fieldkit/core/(commit log)

2017-01-18 Starting the fk-core module schematic. This is pretty rough.
    Basically a combination of the various prototypes we've been using. Gotta
    start somewhere.
    [fk-core.kicad_pcb, fk-core.sch, mcu.sch, periph.sch, power.sch]
2017-01-18 Adding some connectors to get to various power lines.
    [mcu.sch, periph.sch, power.sch]
2017-01-18 Adding GPS connector and BOM placeholder.
    [fk-core.sch, mcu.sch, periph.sch, power.sch]
2017-01-18 Assigning most of the footprints.
    [mcu.sch, periph.sch, power.sch]
2017-01-18 Better footprints, swapping GPS for FGPMMOPA6H
    [fk-core.sch, mcu.sch, periph.sch, power.sch]
2017-01-18 Adding a neopixel, maybe gonna use it. Also some more jumpers.
    [fk-core.sch, mcu.sch, periph.sch, power.sch]
2017-01-18 Tweaking positions.
    [periph.sch, power.sch]
2017-01-19 Fix RTC footprint.
2017-01-19 Cleaning up footprints and libraries.
    [fk-core.sch, mcu.sch, periph.sch, power.sch]
2017-01-19 Adding SMA footprint for GPS and fix XTAL.
    [mcu.sch, periph.sch]
2017-01-19 Adding better SMA connectors and the RFM95
    [fk-core.sch, mcu.sch, periph.sch, power.sch]
2017-01-19 Setting design rules as per OSH.
    [fk-core.kicad_pcb]
2017-01-20 Some footprints, cleaning things up.
    [periph.sch, power.sch]
2017-01-20 Starting with the Mini Ultra Pro, which is extremely close to our core.
    Thanks to RocketScream for the work here. Wish we would have found these
    sooner.
    https://github.com/rocketscream/MiniUltraPro
    [MINI-ULTRA-PRO.kicad_pcb, MINI-ULTRA-PRO.sch]
2017-01-20 Laying out our additions to the MUP pcb. SD/GPS/Fuel gauge.
    [MINI-ULTRA-PRO.kicad_pcb, MINI-ULTRA-PRO.sch]
2017-01-20 Fixing up edge cuts and consolidating pours.
    [MINI-ULTRA-PRO.kicad_pcb]
2017-01-20 Cleanup silkscreen and some tweaks.
    [MINI-ULTRA-PRO.kicad_pcb]
2017-01-20 Better routing of SDA/SCL and some other cleanup.
    [MINI-ULTRA-PRO.kicad_pcb]
2017-03-03 Some layout tweaks, also adding a module header.
    [MINI-ULTRA-PRO.kicad_pcb, MINI-ULTRA-PRO.sch]
2017-03-03 Adding header for modules to PCB.
    [MINI-ULTRA-PRO.kicad_pcb, MINI-ULTRA-PRO.sch]
2017-03-04 Pull ups on SDA/SCL and some tweaks.
    [MINI-ULTRA-PRO.kicad_pcb, MINI-ULTRA-PRO.sch]
2017-03-04 Changing some footprints.
    [MINI-ULTRA-PRO.kicad_pcb]
2017-03-05 Adding logos.
    [MINI-ULTRA-PRO.kicad_pcb]
2017-03-05 MUP based board is the primary board now.
    [MINI-ULTRA-PRO.kicad_pcb, MINI-ULTRA-PRO.sch, fk-core.kicad_pcb, fk-core.sch, mcu.sch, periph.sch, power.sch]
2017-03-06 Incorporating suggestions from Dave.
    * SW1 is awfully close to the RF connection on U7. Can this slide south? Pins 15/15/17/18 are all no connect, having a switch close to that would be easier.
    * If you move J7 to the other side of the board, then we won't need a via in the middle of the RF transmission line there.
    * R16 is sized to bias A1 at about 3 mA. the default is to toggle on/off when it's locking, then go low when the system is locked. Bumping R16 to ~ 1Kohm will half the current, which might be enough for a high brightness LED.
    Done! Thanks!
    * Could J3 get flipped so that the RF path stays on the bottom, instead of running through a Via?
    Done! I had to narrow and get creative with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
    [fk-core.kicad_pcb, fk-core.sch]
2017-03-06 Remove fudicial for now.
    [fk-core.kicad_pcb]
2017-03-06 Mimic LoRa silkscreen on GPS.
    [fk-core.kicad_pcb]
2017-03-06 Label our peripheral header.
    [fk-core.kicad_pcb]
2017-03-06 Adding negative logos and one with text.
    [fk-core.kicad_pcb]
2017-03-06 Move RST label back.
    [fk-core.kicad_pcb]
2017-03-06 Nudge periph header down to clear USB.
    [fk-core.kicad_pcb]
2017-03-06 Some labels.
    [fk-core.kicad_pcb]
2017-03-07 Move things up a directory.
    [fk-core.kicad_pcb, fk-core.sch]
2017-03-31 Moving to use our kicad library.
    [fk-core.kicad_pcb]
2017-03-31 Bump revision.
    [fk-core.kicad_pcb]
2017-04-01 Use kifield to pull BOM in.
    [fk-core.kicad_pcb, fk-core.sch]
2017-04-01 Wire up new wire ant hole and new switch.
    [fk-core.kicad_pcb]
2017-04-11 Fix decoupling network on MAX1704. Align lables for printing help sheet.
    [fk-core.kicad_pcb, fk-core.sch]
2017-04-11 Adding some firmware to test the board's functionality.
2017-04-11 Fix the switch footprint.
    [fk-core.kicad_pcb, fk-core.sch]
2017-04-11 Update microsd part # to one that's in stock.
    [fk-core.kicad_pcb, fk-core.sch]
2017-04-11 Change SD CS to pin 12.
    [fk-core.kicad_pcb, fk-core.sch]
2017-04-12 Incorporate a wifi module (ATWINC1500) Whew!
    [fk-core.kicad_pcb, fk-core.sch]
2017-04-13 Fixing edge cuts and dimensions.
    [fk-core.kicad_pcb]
2017-04-13 Use correct SD pin. Why did I use pin 13?
    [test.ino]
2017-04-13 Nudge things closer to the edges after our widening.
    [fk-core.kicad_pcb]
2017-04-13 Adding LED indicators, 3 of them.
    [fk-core.kicad_pcb, fk-core.sch]
2017-04-13 Fix label for RST.
    [fk-core.kicad_pcb]
2017-04-17 Plotting gerbers.
    [fk-core-B.Cu.gbr, fk-core-B.Mask.gbr, fk-core-B.Paste.gbr, fk-core-B.SilkS.gbr, fk-core-Edge.Cuts.gbr, fk-core-F.Cu.gbr, fk-core-F.Mask.gbr, fk-core-F.Paste.gbr]
2017-04-17 Correct part, wrong package.
    [fk-core.sch]
2017-06-07 Fix solder paste layer on other SMA, weird.
    [fk-core-B.Cu.gbr, fk-core-B.Mask.gbr, fk-core-B.Paste.gbr, fk-core-B.SilkS.gbr, fk-core-Edge.Cuts.gbr, fk-core-F.Cu.gbr, fk-core-F.Mask.gbr, fk-core-F.Paste.gbr]
2017-06-09 Fix traces that I screwed up moving the USB.
    [fk-core-B.Cu.gbr, fk-core-B.Mask.gbr, fk-core-B.Paste.gbr, fk-core-B.SilkS.gbr, fk-core-Edge.Cuts.gbr, fk-core-F.Cu.gbr, fk-core-F.Mask.gbr, fk-core-F.Paste.gbr]
2017-06-09 Fix paste layer on other SMA again.
    [fk-core.kicad_pcb]
2017-06-10 Moving gerbers.
    [fk-core-2.kicad_pcb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]
2017-06-20 Changed passive footprints to 0603.
    [fk-core.kicad_pcb, fk-core.sch]
2017-06-20 Convert dual charge LED to two separate LEDs.
    [fk-core.kicad_pcb, fk-core.sch]
2017-06-20 Add part name for SWD header.
    [fk-core.kicad_pcb, fk-core.sch]
2017-06-20 Fix inductor part number.
    [fk-core.sch]
2017-06-20 Bump version on PCB.
    [fk-core.kicad_pcb]
2017-06-20 Change radio decoupling cap to 47uF
    [fk-core.sch]
2017-06-20 Hide some random text.
    [fk-core.kicad_pcb]
2017-06-21 Adding 24AA02E64
    [fk-core.kicad_pcb, fk-core.sch]
2017-06-21 Non oval front holes on USB.
    [fk-core.kicad_pcb]
2017-06-22 Add part numbers for wifi module.
    [fk-core.sch]
2017-06-23 Move module connector out of the wifi's way.
    [fk-core.kicad_pcb]
2017-06-26 Finish up moving stuff to lower end of the board.
    [fk-core-2.kicad_pcb, fk-core.kicad_pcb, fk-core.sch]
2017-06-26 Fix logos.
    [fk-core.kicad_pcb]
2017-06-26 Minor tweaks.
    [fk-core.kicad_pcb]
2017-06-26 Moved bom tools to the kicad repo.
2017-06-27 Fix alignment on power header.
    [fk-core.kicad_pcb]
2017-07-25 Some small BOM changes.
    [fk-core.sch]
2017-09-29 Adding prices and updating a few BOM things.
    [fk-core.sch]
2017-09-30 Consistent value.
    [fk-core.sch]
2017-11-17 Changed inductors to 0603 part numbers.
    [fk-core.kicad_pcb, fk-core.sch]
2017-11-28 Fix USB connector, luckily caught this.
    [fk-core-B.Cu.gbr, fk-core-B.Mask.gbr, fk-core-B.Paste.gbr, fk-core-B.SilkS.gbr, fk-core-Edge.Cuts.gbr, fk-core-F.Cu.gbr, fk-core-F.Mask.gbr, fk-core-F.Paste.gbr]
2017-11-29 Rounding corners of the PCB.
    [fk-core-B.Cu.gbr, fk-core-B.Mask.gbr, fk-core-B.Paste.gbr, fk-core-B.SilkS.gbr, fk-core-Edge.Cuts.gbr, fk-core-F.Cu.gbr, fk-core-F.Mask.gbr, fk-core-F.Paste.gbr]
2017-12-18 Make labels easier to read. Some silkscreen fixes.
    [fk-core.kicad_pcb]
2017-12-19 Consolidate debug logging code, send to Serial1.
    Just a quick change to verify things are working on this board. Can't
    use the regular Serial because the USB traces weren't hooked up :/
2017-12-19 Connecting USB traces. FK-24
    [fk-core.kicad_pcb]
2017-12-19 Footprint for 24AA02E64 had VSS/VCC swapped.
    [fk-core.kicad_pcb, fk-core.sch]
2017-12-19 Using new footprint for programming header.
    I thought this had been resolved. Using a whole new footprint to ensure
    that we don't mismatch this again.
    [fk-core.kicad_pcb, fk-core.sch]
2017-12-19 Adding a user button.
    [fk-core.kicad_pcb, fk-core.sch]
2017-12-19 Cleaning up some of the silkscreen.
    [fk-core.kicad_pcb]
2017-12-19 Bump version to v0.5 and plot.
    [fk-core-B.Cu.gbr, fk-core-B.Mask.gbr, fk-core-B.Paste.gbr, fk-core-B.SilkS.gbr, fk-core-Edge.Cuts.gbr, fk-core-F.Cu.gbr, fk-core-F.Mask.gbr, fk-core-F.Paste.gbr]
2017-12-21 Removing unused pins. Shortening 19 pin header on one side to 12.
    [fk-core.kicad_pcb, fk-core.sch]
2017-12-21 Add new ISL8541x stuff for higher current and more efficient 3v3.
    [fk-core.kicad_pcb, fk-core.sch]
2017-12-21 User switch was on D5, which was radio CS. Need better labels in schematic.
    [fk-core.kicad_pcb, fk-core.sch]
2017-12-21 Using descriptive labels on PCB for all select lines, etc...
    [fk-core.kicad_pcb, fk-core.sch]
2017-12-21 Cosmetics. Sectioned the schematic :)
    [fk-core.kicad_pcb, fk-core.sch]
2017-12-21 Rotating the PCB, more friendly on widescreens.
    This is very disorientating.
    [fk-core.kicad_pcb]
2017-12-21 More label fixes.
    [fk-core.kicad_pcb, fk-core.sch]
2017-12-22 Flash LEDs if checks fail.
    [main.cpp]
2017-12-27 Connect QSTRT and ALT pins on the Max1704
    [fk-core.kicad_pcb, fk-core.sch]
2017-12-27 Clearing some DRC proximity warnings.
    [fk-core.kicad_pcb]
2017-12-28 Fix dimensions on PCB.
    [fk-core.kicad_pcb]
2017-12-28 Removed unnecessary pins on bottom header.
    [fk-core.kicad_pcb, fk-core.sch]
2017-12-28 Removed unnecessary pins on top header.
    [fk-core.kicad_pcb, fk-core.sch]
2017-12-29 Label fixes. Also cleaned up some routing in a few places.
    [fk-core.kicad_pcb]
2018-01-06 Leave LEDs on.
2018-01-09 Moving programming header to make connector room.
    [fk-core.kicad_pcb]
2018-01-09 Adding a ClikMate connector for Serial5
    [fk-core.kicad_pcb, fk-core.sch]
2018-01-09 Dropping the SPI breakout header.
    [fk-core.kicad_pcb, fk-core.sch]
2018-01-09 Move D13 to edge of the board.
    [fk-core.kicad_pcb]
2018-01-10 Pretty significant layout change to make room for connectors.
    This looks much cleaner overall, though I hope I didn't fuck anything up.
    [fk-core.kicad_pcb]
2018-01-10 Add the new connector, wire things up and do some cleanup.
    Also spaced out LEDs.
    [fk-core.kicad_pcb, fk-core.sch]
2018-01-10 Reroute GPS 3v3.
    [fk-core.kicad_pcb]
2018-01-10 Organizing and cleaning up.
    [fk-core.kicad_pcb]
2018-01-10 Rearrange the new 3v3 regulator. Some cleanup and plot.
    [fk-core-B.Cu.gbr, fk-core-B.Mask.gbr, fk-core-B.Paste.gbr, fk-core-B.SilkS.gbr, fk-core-Edge.Cuts.gbr, fk-core-F.Cu.gbr, fk-core-F.Mask.gbr, fk-core-F.Paste.gbr]
2018-01-10 Change power inductor footprint.
    [fk-core-B.Cu.gbr, fk-core-B.Mask.gbr, fk-core-B.Paste.gbr, fk-core-B.SilkS.gbr, fk-core-Edge.Cuts.gbr, fk-core-F.Cu.gbr, fk-core-F.Mask.gbr, fk-core-F.Paste.gbr]
2018-01-10 Adding parts.
    [fk-core.sch]
2018-01-11 Adding some shapes :)
    [fk-core.kicad_pcb]
2018-01-25 Add some docs, move labels around on the board.
    [fk-core.kicad_pcb]
2018-03-08 Copied FkNat, dropped sensors and adding LoRa.
    [fk-core.kicad_pcb, fk-core.sch]
2018-03-09 Fixing labels.
    [fk-core.kicad_pcb]
2018-03-21 Fix USB footprint with the oval drills.
    [fk-core.kicad_pcb, fk-core.sch]
2018-03-21 Moving some parts in from the edge.
    [fk-core.kicad_pcb]
2018-03-21 Adding some pin 1 markers.
    [fk-core.kicad_pcb]
2018-03-21 Nudge the coincell away from LoRa.
    [fk-core.kicad_pcb]
2018-05-01 Switch to our RadioHead fork.
2018-05-01 Migrate to arduino-logging.
2018-05-07 Adding NFET for peripherals.
    [fk-core.kicad_pcb, fk-core.sch]
2018-05-21 Updating BOM details.
    [fk-core.sch]
2018-06-18 Expose Vbus on the module connector.
    [fk-core.kicad_pcb, fk-core.sch]
2018-06-18 Adding fiducials.
    [fk-core.kicad_pcb, fk-core.sch]
2018-06-18 Separate USB and SD a little more.
    [fk-core.kicad_pcb, fk-core.sch]
2018-06-18 Plot gerbers for new design.
    [fk-core-B.Cu.gbr, fk-core-B.Mask.gbr, fk-core-B.Paste.gbr, fk-core-B.SilkS.gbr, fk-core-Edge.Cuts.gbr, fk-core-F.Cu.gbr, fk-core-F.Mask.gbr, fk-core-F.Paste.gbr]
2018-06-28 Nuke old design.
    [fk-core-B.Cu.gbr, fk-core-B.Mask.gbr, fk-core-B.Paste.gbr, fk-core-B.SilkS.gbr, fk-core-Edge.Cuts.gbr, fk-core-F.Cu.gbr, fk-core-F.Mask.gbr, fk-core-F.Paste.gbr]
2018-06-28 Fix pads on wifi. Add back fudicials. Remove vias in pads.
    [fk-core.kicad_pcb, fk-core.sch]
2018-06-29 Add JST for solar panel. Bump version to v0.8
    [fk-core.kicad_pcb, fk-core.sch]
2018-07-05 Adding jumpers for external switches.
    [fk-core.kicad_pcb]
2018-07-05 Update test firmware for second generation boards.
    Pins moved around. I'm also no longer testing SD using the SD lib.
    [main.cpp]
2018-07-06 Add TPS2041B high side switch.
    [fk-core.kicad_pcb, fk-core.sch]
2018-07-06 Add logos and some other silk cleanup. Plot.
    [fk-core-B.Cu.gbr, fk-core-B.Mask.gbr, fk-core-B.Paste.gbr, fk-core-B.SilkS.gbr, fk-core-Edge.Cuts.gbr, fk-core-F.Cu.gbr, fk-core-F.Mask.gbr, fk-core-F.Paste.gbr]
2018-07-14 Moving labels around.
    [fk-core.kicad_pcb]
2018-07-23 Add external switch molex. Replace 3 LEDs with SK6812
    [fk-core.kicad_pcb, fk-core.sch]
2018-07-23 Board is now 100x36mm
    [fk-core.kicad_pcb]
2018-07-23 Move solar JST to top of the board.
    [fk-core.kicad_pcb]
2018-07-24 Replace peripheral switch with TPS2052B and use other port for GPS.
    [fk-core.kicad_pcb, fk-core.sch]
2018-07-24 Fix load switch part.
    [fk-core.kicad_pcb, fk-core.sch]
2018-07-25 Upgrade to Kicad 5.
    [fk-core-2018-07-25-09-58-59.sch, fk-core.kicad_pcb]
2018-07-27 Updating footprints for JST and USB to support vertical entry parts.
    [fk-core.kicad_pcb]
2018-07-27 Adding GPS-735 connector. Plotting.
    [fk-core-B.Cu.gbr, fk-core-B.Mask.gbr, fk-core-B.Paste.gbr, fk-core-B.SilkS.gbr, fk-core-Edge.Cuts.gbr, fk-core-F.Cu.gbr, fk-core-F.Mask.gbr, fk-core-F.Paste.gbr]
2018-07-27 Fix an ugly trace.
    [fk-core-B.Cu.gbr, fk-core-B.Mask.gbr, fk-core-B.Paste.gbr, fk-core-B.SilkS.gbr, fk-core-Edge.Cuts.gbr, fk-core-F.Cu.gbr, fk-core-F.Mask.gbr, fk-core-F.Paste.gbr]
2018-07-28 Add lines for extra LoRa IRQs
    [fk-core-B.Cu.gbr, fk-core-B.Mask.gbr, fk-core-B.Paste.gbr, fk-core-B.SilkS.gbr, fk-core-Edge.Cuts.gbr, fk-core-F.Cu.gbr, fk-core-F.Mask.gbr, fk-core-F.Paste.gbr]
2018-07-30 Adding module 3v3 regulator and using an easier to source linear one.
    [fk-core-B.Cu.gbr, fk-core-B.Mask.gbr, fk-core-B.Paste.gbr, fk-core-B.SilkS.gbr, fk-core-Edge.Cuts.gbr, fk-core-F.Cu.gbr, fk-core-F.Mask.gbr, fk-core-F.Paste.gbr]
2018-07-30 Adding backup voltage regulator. Silkscreen bottom jumpers.
    [fk-core-B.Cu.gbr, fk-core-B.Mask.gbr, fk-core-B.Paste.gbr, fk-core-B.SilkS.gbr, fk-core-Edge.Cuts.gbr, fk-core-F.Cu.gbr, fk-core-F.Mask.gbr, fk-core-F.Paste.gbr]
2018-07-30 Trying out adding a writable area to the PCB.
    [fk-core-B.Cu.gbr, fk-core-B.Mask.gbr, fk-core-B.Paste.gbr, fk-core-B.SilkS.gbr, fk-core-Edge.Cuts.gbr, fk-core-F.Cu.gbr, fk-core-F.Mask.gbr, fk-core-F.Paste.gbr]
2018-08-20 Move labels around for help in assembly.
    [fk-core.kicad_pcb, fk-core.sch]
2018-08-20 Fix missing GND connection on voltage. Fix SK6812.
    [fk-core.kicad_pcb, fk-core.sch]
2018-08-20 Bump version. Plot.
    [fk-core-B.Cu.gbr, fk-core-B.Mask.gbr, fk-core-B.Paste.gbr, fk-core-B.SilkS.gbr, fk-core-Edge.Cuts.gbr, fk-core-F.Cu.gbr, fk-core-F.Mask.gbr, fk-core-F.Paste.gbr]
2018-08-20 Swap GPS735 RX/TX.
    [fk-core-B.Cu.gbr, fk-core-B.Mask.gbr, fk-core-B.Paste.gbr, fk-core-B.SilkS.gbr, fk-core-Edge.Cuts.gbr, fk-core-F.Cu.gbr, fk-core-F.Mask.gbr, fk-core-F.Paste.gbr]
2018-08-22 Consistent part values across our schematics.
    [fk-core.sch]
2018-08-22 Part updates.
    [fk-core.kicad_pcb, fk-core.sch]
2018-08-24 Fixup rescues and a majority of DRC checks.
    [fk-core.kicad_pcb, fk-core.sch]
2018-08-24 Include pin numbers in signals.
    [fk-core.kicad_pcb, fk-core.sch]
2018-08-28 Update flash FP so we can move to our new IC. Longer pins.
    [fk-core.kicad_pcb, fk-core.sch]
2018-08-28 Consistency in part values
    [fk-core.sch]
2018-08-29 Cleanup schematic wks.
2018-08-30 Fix SD landing.
    [fk-core.sch]
2018-08-30 Drop FuelGauge polling in test. Update LED afterwards.
2018-09-07 Add some bypass caps on GPS 3v3, see if fix issues are power related.
    [fk-core.kicad_pcb, fk-core.sch]
2018-09-07 Add a bead on the GPS 3v3 supply too.
    [fk-core.kicad_pcb, fk-core.sch]
2018-09-07 Plot and bump version.
    [fk-core-B.Cu.gbr, fk-core-B.Mask.gbr, fk-core-B.Paste.gbr, fk-core-B.SilkS.gbr, fk-core-Edge.Cuts.gbr, fk-core-F.Cu.gbr, fk-core-F.Mask.gbr, fk-core-F.Paste.gbr]
2018-09-20 Fix Rx/Tx on backup GPS.
    [fk-core.kicad_pcb, fk-core.sch]
2018-10-09 Always setup the radio related pins, even if no radio configured.
    This ensures that when the radio is disabled but present it's not screwing with
    the SPI bus.
2018-11-07 Adding some pull downs.
    [fk-core-B.Cu.gbr, fk-core-B.Mask.gbr, fk-core-B.Paste.gbr, fk-core-B.SilkS.gbr, fk-core-Edge.Cuts.gbr, fk-core-F.Cu.gbr, fk-core-F.Mask.gbr, fk-core-F.Paste.gbr]
2018-11-07 Update version.
    [fk-core-B.Cu.gbr, fk-core-B.Mask.gbr, fk-core-B.Paste.gbr, fk-core-B.SilkS.gbr, fk-core-Edge.Cuts.gbr, fk-core-F.Cu.gbr, fk-core-F.Mask.gbr, fk-core-F.Paste.gbr]
2018-11-08 Font sizes.
    [fk-core.sch]
2018-11-29 Initial move of board from 2 layer to 4 layer
    [fk-core.kicad_pcb, fk-core.sch]
2018-11-29 Started moving the USB and associated components
    [fk-core.kicad_pcb]
2018-11-29 Finished most power stuff, rotating the wifi chip
    [fk-core.kicad_pcb]
2018-11-29 Finished re-routing the power section
    [fk-core.kicad_pcb]
2018-11-29 Added keepout under antenna
    [fk-core.kicad_pcb]
2018-12-03 Clered DRC errors and reoriented text
    [fk-core.kicad_pcb]
2018-12-06 Shuffled the actual components, getting ready to re-layout
    [fk-core.kicad_pcb, fk-core.sch]
2018-12-07 Shuffled a few more connectors top side and drew the Periph Power plane
    [fk-core.kicad_pcb, fk-core.sch]
2018-12-07 Deleted the mounting holes by accident, grabbing their location from the master branch
    [fk-core.kicad_pcb, fk-core.sch]
2018-12-07 Recovered mounting hole position
    [fk-core.kicad_pcb]
2018-12-07 Changed out the GPS enable, added a divider for VBAT and cleaned up more signals
    [fk-core.kicad_pcb, fk-core.sch]
2018-12-07 Finished moving all parts, finishing up routing traces
    [fk-core.kicad_pcb]
2018-12-07 Finished layout, cleaing up schematic and adding a few small changes like caps on the button inputs
    [fk-core.kicad_pcb, fk-core.sch]
2018-12-07 Added debounce for buttons and moved them to their own part of the schematic
    [fk-core.sch]
2018-12-07 Finished the LoRa Shuffle
    [fk-core.kicad_pcb, fk-core.sch]
2018-12-11 Added STC3100 fuel cell circuit
    [fk-core.kicad_pcb, fk-core.sch]
2018-12-11 Swapped out power connectors for the vertical version
    [fk-core.kicad_pcb, fk-core.sch]
2018-12-11 Changed out vertical mount USB connector and added secondary micro usb connector on the bottom side
    [fk-core.kicad_pcb, fk-core.sch]
2018-12-11 Rerouted top trace for VBUS to a pour, added logos back in
    [fk-core.kicad_pcb]
2018-12-11 Reduced the solderpaste opening on the connectors and generated gerbers
    [fk-core-B.Cu.gbr, fk-core-B.Mask.gbr, fk-core-B.Paste.gbr, fk-core-B.SilkS.gbr, fk-core-Edge.Cuts.gbr, fk-core-F.Cu.gbr, fk-core-F.Mask.gbr, fk-core-F.Paste.gbr]
2018-12-12 Rescue new parts.
    [fk-core.sch]
2018-12-21 Moving labels for printing assemby sheets.
    [fk-core.kicad_pcb]
2018-12-22 New battery gauge testing code.
2018-12-26 Echo battery information using the new gauge.
2018-12-27 Moved UID chip and started moving components to the top side of the board
    [fk-core.kicad_pcb, fk-core.sch]
2018-12-27 Swapped signals again to remove resistor strapping
    [fk-core.sch]
2018-12-27 Changed connections on the 9 pin connector
    [fk-core.kicad_pcb, fk-core.sch]
2018-12-27 DRC passed and gerbers generated
    [fk-core-B.Cu.gbr, fk-core-B.Mask.gbr, fk-core-B.Paste.gbr, fk-core-B.SilkS.gbr, fk-core-Edge.Cuts.gbr, fk-core-F.Cu.gbr, fk-core-F.Mask.gbr, fk-core-F.Paste.gbr]
2018-12-27 Added SWD test points to bottom of board, removed Vbus from 5 pin connector and renamed Core connector bus
    [fk-core-B.Cu.gbr, fk-core-B.Mask.gbr, fk-core-B.Paste.gbr, fk-core-B.SilkS.gbr, fk-core-Edge.Cuts.gbr, fk-core-F.Cu.gbr, fk-core-F.Mask.gbr, fk-core-F.Paste.gbr]
2018-12-28 Panelized core v0.15 and generated gerbers
    [fk-core-v0.15-01x04-B.Cu.gbr, fk-core-v0.15-01x04-B.Mask.gbr, fk-core-v0.15-01x04-B.Paste.gbr, fk-core-v0.15-01x04-B.SilkS.gbr, fk-core-v0.15-01x04-Edge.Cuts.gbr, fk-core-v0.15-01x04-F.Cu.gbr, fk-core-v0.15-01x04-F.Mask.gbr, fk-core-v0.15-01x04-F.Paste.gbr]
2019-01-02 Dump battery gauge readings.
2019-01-03 Toggle peripherals during test so we can look at the battery.
2019-01-04 Display charge delta.
2019-01-15 Rescue schematic components.
    [fk-core.sch]
2019-01-23 Expanded mounting holes and board perimeter.
    [fk-core.kicad_pcb]
2019-01-23 Changed R21 value for faster battery charging.
    [fk-core.kicad_pcb, fk-core.sch]
2019-01-23 Updated programming header.
    [fk-core.kicad_pcb]
2019-01-23 Updated Button Footprint.
    [fk-core.kicad_pcb]
2019-01-23 Enlarged 0603 Polarity Marking.
    [fk-core.kicad_pcb]
2019-02-11 DFN footprint changes in Core and Panelized Core.
    [fk-core-v0.15-01x04-B.Cu.gbr, fk-core-v0.15-01x04-B.Mask.gbr, fk-core-v0.15-01x04-B.Paste.gbr, fk-core-v0.15-01x04-B.SilkS.gbr, fk-core-v0.15-01x04-Edge.Cuts.gbr, fk-core-v0.15-01x04-F.Cu.gbr, fk-core-v0.15-01x04-F.Mask.gbr, fk-core-v0.15-01x04-F.Paste.gbr]
2019-03-12 Propogated manufacturing enhancements to panelized PCB
    [fk-core-v0.15A-01x04.kicad_pcb]
2019-03-14 Indicate top passed with solid yellow.
    This also turns red if the top fails and then will still do the yellow flash
    if the only things that failed are the ones that need attention.
    [check_core.cpp]
2019-03-18 Log pass/fail and retry the gauge a few times.
    [check_core.cpp, main.cpp]
2019-03-22 Report battery voltage in gauge test.
2019-03-28 Allow disabling of fuel gauge test.
    I'm doing this simply because I have a board here that won't work and I wanna
    use it for in house testing.
    [check_core.cpp]
2019-10-12 Use my repo for ArduinoSound
